Ahmed4Mars/QITOUS-VTOL/print-files/ailerons_servo_wingtip_PLA.3mf

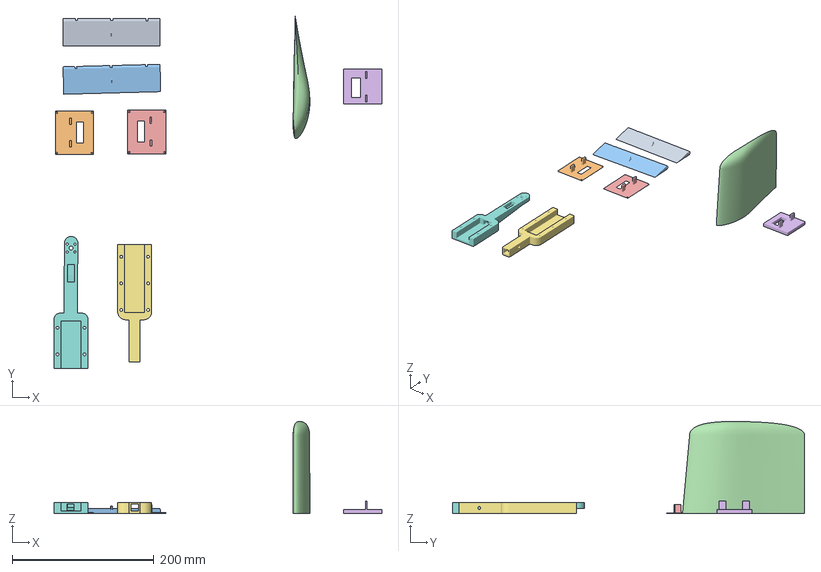
[picture p19: CAD file, 2026-10-22]
print-files/ailerons_servo_wingtip_PLA.3mf
462.8 x 497.1 x 129.9 mm
Aileron x 2
Servo COver x 2
Main 3
Front Rod_A
Front Rod_B
