Ahmed4Mars/QITOUS-VTOL/print-files/fuselage_landing-legs_v8.3mf

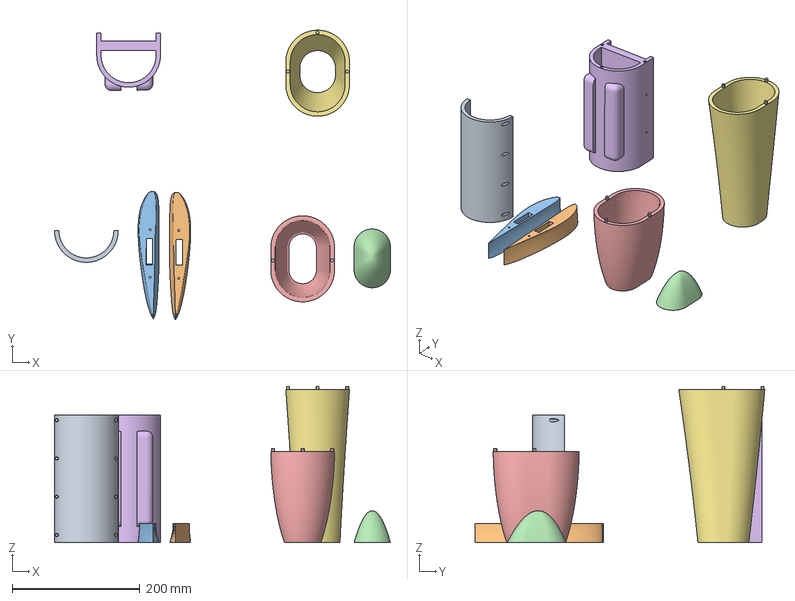
[picture p20: CAD file, 2026-10-22]
print-files/fuselage_landing-legs_v8.3mf
526.9 x 454.3 x 245.0 mm
Cover
Fuslage Linkage x 2
Nose
cockpit
main fueslage
tail section
