Ahmed4Mars/QITOUS-VTOL/print-files/fuselage.3mf

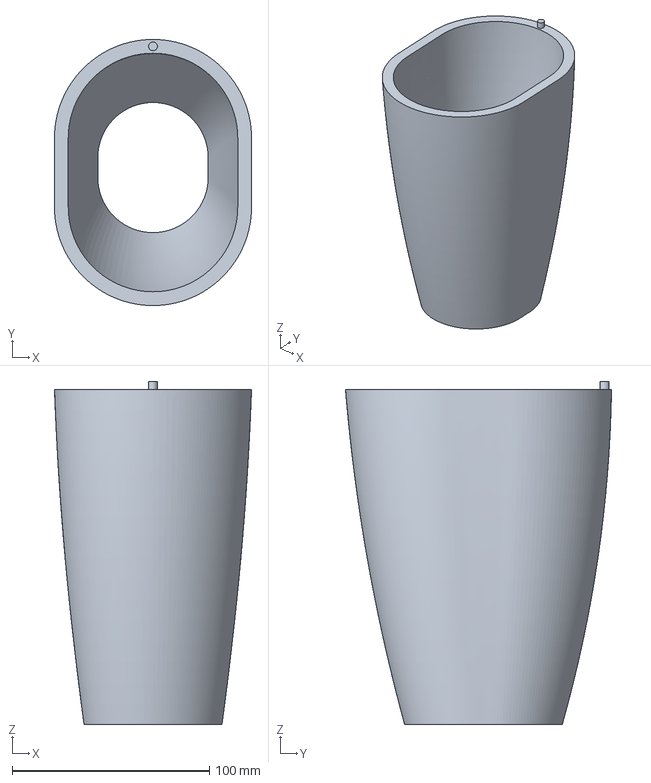
[picture p21: CAD file, 2026-10-22]
print-files/fuselage.3mf
100.0 x 135.0 x 174.0 mm
