Ahmed4Mars/QITOUS-VTOL/print-files/engine_mounts_v3.3mf

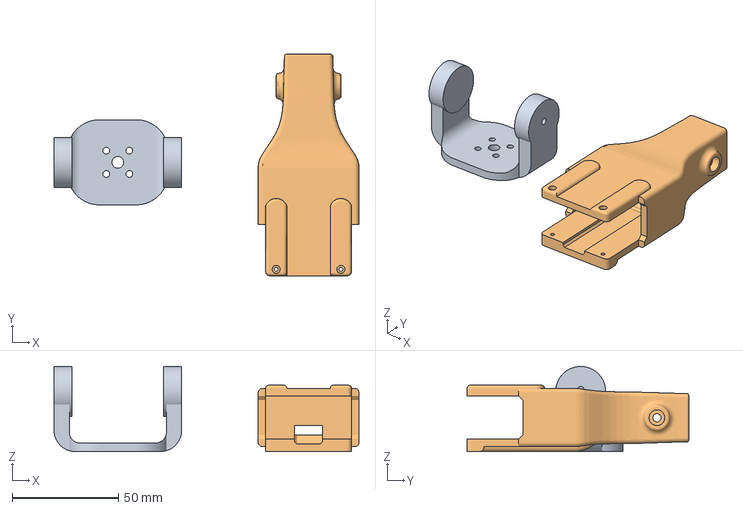
[picture p22: CAD file, 2026-10-22]
print-files/engine_mounts_v3.3mf
143.3 x 104.2 x 40.0 mm
all.stl_6
