Ahmed4Mars/QITOUS-VTOL/print-files/tail.3mf

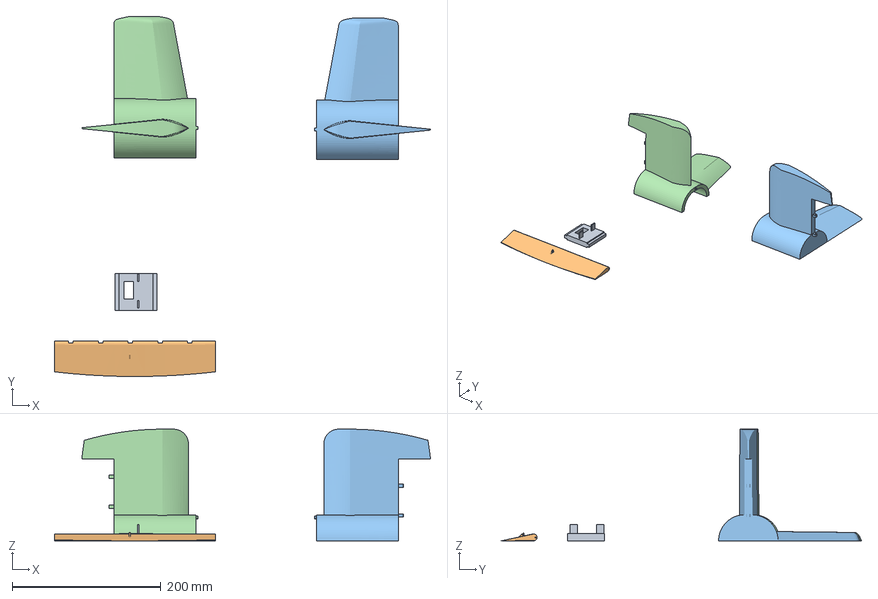
[picture p23: CAD file, 2026-10-22]
print-files/tail.3mf
505.2 x 483.5 x 150.0 mm
R-elevator
stabilizers_A
stabilizers_B
