Ahmed4Mars/QITOUS-VTOL/print-files/wing_PLA-plus.3mf

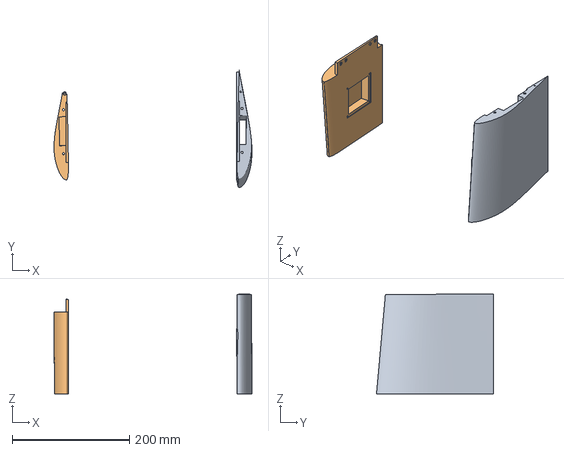
[picture p24: CAD file, 2026-10-22]
print-files/wing_PLA-plus.3mf
338.3 x 200.0 x 170.2 mm
Wing 1
Wing 2
